kiyo9w/Autonomous-Car-IoT/Rescue_Rover_Report/frontmatter/acknowledgments.tex

% frontmatter/acknowledgments.tex - Acknowledgments
% ==================================================

\chapter*{Acknowledgments}
\addcontentsline{toc}{chapter}{Acknowledgments}

We would like to express our sincere gratitude to all those who have contributed to the successful completion of this project.

\vspace{0.5cm}

First and foremost, we extend our heartfelt thanks to our instructor, \textbf{Professor Du Dinh Vien}, for their invaluable guidance, continuous support, and constructive feedback throughout the development of the Rescue Rover project. Their expertise in networking and data communication has been instrumental in shaping our technical approach.

\vspace{0.5cm}

We are grateful to the \textbf{School of Information and Communication Technology} at Hanoi University of Science and Technology for providing us with the necessary resources, laboratory facilities, and academic environment to conduct this research.

\vspace{0.5cm}

Special thanks to our fellow classmates and lab mates who provided helpful discussions, testing support, and moral encouragement during challenging phases of development.

\vspace{0.5cm}

We also acknowledge the open-source community for their contributions to the tools and libraries we used in this project, including the Arduino framework, NiceGUI, YOLOv8, and various Python packages that made our implementation possible.

\vspace{0.5cm}

Finally, we thank our families for their unwavering support and understanding during the long hours dedicated to this project.

\vspace{1cm}

\hfill --- The Rescue Rover Team
