kiyo9w/Autonomous-Car-IoT/Rescue_Rover_Report/frontmatter/acronyms.tex

% frontmatter/acronyms.tex - List of Abbreviations
% =================================================

\chapter*{List of Abbreviations}
\addcontentsline{toc}{chapter}{List of Abbreviations}

\begin{longtable}{@{}ll@{}}
    \toprule
    \textbf{Abbreviation} & \textbf{Full Form} \\
    \midrule
    \endhead
    
    % Hardware & Electronics
    ADC     & Analog-to-Digital Converter \\
    GPIO    & General Purpose Input/Output \\
    I\textsuperscript{2}C & Inter-Integrated Circuit \\
    LED     & Light Emitting Diode \\
    MCU     & Microcontroller Unit \\
    PCB     & Printed Circuit Board \\
    PSRAM   & Pseudo Static Random Access Memory \\
    PWM     & Pulse Width Modulation \\
    SPI     & Serial Peripheral Interface \\
    UART    & Universal Asynchronous Receiver-Transmitter \\
    
    \midrule
    % Communication Protocols
    ESP-NOW & Espressif's Proprietary Wireless Protocol \\
    HTTP    & Hypertext Transfer Protocol \\
    JSON    & JavaScript Object Notation \\
    MJPEG   & Motion JPEG \\
    REST    & Representational State Transfer \\
    TCP     & Transmission Control Protocol \\
    UDP     & User Datagram Protocol \\
    WiFi    & Wireless Fidelity \\
    
    \midrule
    % AI & Computer Vision
    AI      & Artificial Intelligence \\
    CNN     & Convolutional Neural Network \\
    CV      & Computer Vision \\
    FPS     & Frames Per Second \\
    LLM     & Large Language Model \\
    ML      & Machine Learning \\
    VLM     & Vision Language Model \\
    YOLO    & You Only Look Once \\
    
    \midrule
    % Project-Specific
    API     & Application Programming Interface \\
    IoT     & Internet of Things \\
    ROV     & Remotely Operated Vehicle \\
    SDK     & Software Development Kit \\
    UI      & User Interface \\
    
    \midrule
    % Sensors & Components
    OV2640  & OmniVision 2640 Camera Sensor \\
    L298N   & Dual H-Bridge Motor Driver IC \\
    ToF     & Time of Flight \\
    
    \midrule
    % Standards & Units
    Hz      & Hertz \\
    kHz     & Kilohertz \\
    MHz     & Megahertz \\
    mA      & Milliampere \\
    mAh     & Milliampere-hour \\
    V       & Volt \\
    
    \bottomrule
\end{longtable}
