kiyo9w/Autonomous-Car-IoT/Rescue_Rover_Report/frontmatter/declaration.tex

% frontmatter/declaration.tex - Academic Declaration
% ===================================================

\chapter*{Declaration}
\addcontentsline{toc}{chapter}{Declaration}

We hereby declare that this project report titled \textbf{``Rescue Rover: An IoT-Based Autonomous Rescue Robot System''} submitted to \textbf{Hanoi University of Science and Technology} is a record of original work done by us under the guidance of our supervisor.

\vspace{1cm}

We further declare that:

\begin{enumerate}
    \item The work presented in this report has not been submitted elsewhere for any other degree or professional qualification.
    
    \item All sources of information and literature used in this work have been duly acknowledged through appropriate citations and references.
    
    \item The software code, hardware designs, and methodologies presented here are our own original work, except where explicitly stated otherwise.
    
    \item We understand that any instance of academic dishonesty may result in disciplinary action as per the university regulations.
\end{enumerate}

\vspace{2cm}

\noindent
\begin{tabular}{@{}p{0.45\textwidth}p{0.45\textwidth}@{}}
    \hrulefill & \hrulefill \\
    Ngo Thanh Trung & Date \\[1.5cm]
    \hrulefill & \hrulefill \\
    Pham Thai Duong & Date \\[1.5cm]
    \hrulefill & \hrulefill \\
    Nguyen Van Duc & Date \\[1.5cm]
    \hrulefill & \hrulefill \\
    Le Quang Huy & Date \\
\end{tabular}
