kiyo9w/Autonomous-Car-IoT/Rescue_Rover_Report/frontmatter/titlepage.tex

% frontmatter/titlepage.tex - Title Page
% =======================================

\begin{titlepage}
    \centering
    
    % University Logo (placeholder - add your university logo)
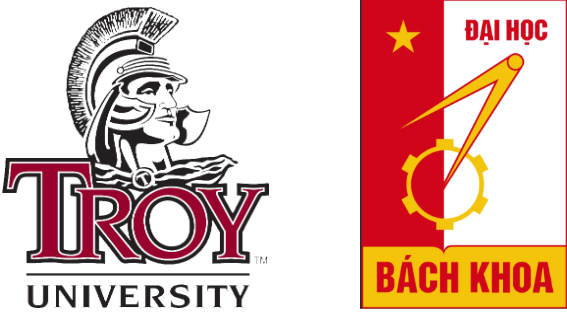
[picture p37: Rescue_Rover_Report/figures/university_logo.png]
    
    
    \vspace{0.5cm}
    
    {\scshape\LARGE Hanoi University of Science and Technology \par}
    \vspace{0.3cm}
    {\scshape\Large Faculty of Mathematics and Computer Science \par}
    
    \vspace{2cm}
    
    {\huge\bfseries Rescue Rover \par}
    \vspace{0.3cm}
    {\Large\itshape An IoT-Based Autonomous Rescue Robot System \par}
    
    \vspace{2cm}
    
    {\Large Project Report \par}
    \vspace{0.3cm}
    {\large CS 4445 - Data Communication and Networking \par}
    
    \vfill
    
    % Authors
    \begin{tabular}{rl}
        \textbf{Team Members:} & \\
        & Ngo Thanh Trung (1677469) \\
        & Pham Thai Duong (1677593) \\
        & Nguyen Duy Duc (1624838) \\
        & Le Quang Huy (1677645) \\
    \end{tabular}
    
    \vspace{1cm}
    
    \begin{tabular}{rl}
        \textbf{Instructor:} & Professor Du Dinh Vien \\
    \end{tabular}
    
    \vfill
    
    % Date
    {\large January 2026 \par}
    
\end{titlepage}
