kiyo9w/Autonomous-Car-IoT/Rescue_Rover_Report/figures/hardware/dc_motor_gearbox.jpeg

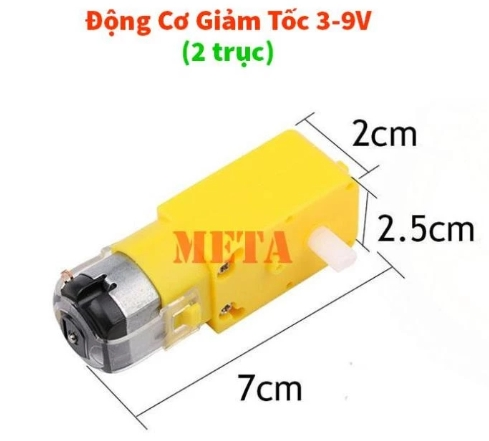
Rescue_Rover_Report/figures/hardware/dc_motor_gearbox.jpeg
