kiyo9w/Autonomous-Car-IoT/context/project_context/shopping.md

Here is the comprehensive cart audit and BOM analysis converted into structured Markdown, maintaining the technical details and pricing from the source documents.

---

# Final Comprehensive Cart Audit

## 1. Inventory Check: Current Orders

**Status:** **95% Complete** (Electronics & Mechanical largely secured) 

### Electronics (All Present)

| Component | Status | Price (VND) | Notes |
| --- | --- | --- | --- |
| **ESP32-S3 Sense N16R8** | Shipping | 163,800₫ | Ready to ship (Dec 07-12) 

 |
| **ESP32 DevKit CP2102 38P** | Ordered | 109,998₫ | Shop: Kho Linh Kiện Giá Si 

 |
| **L298N Motor Driver** | Ordered | 48,398₫ | Shop: A Linh Kiện 

 |
| **LM2596 Buck 5V/3A** | Ordered | 16,748₫ | Shop: Điện Tử Dân Dụng 24H 

 |
| **HC-SR04 Ultrasonic** | Ordered | 38,449₫ | Shop: Nhập Si Linh Kiện 

 |
| **MicroSD 16GB Kingston** | Ordered | 92,198₫ | Shop: Rflashdrive.vn 

 |
| **Samsung 20R Battery (x2)** | Ordered | 74,050₫ | 44,999₫/each 

 |
| **18650 Holder 2S** | Ordered | 36,058₫ | Series connection (Nối tiếp) 

 |
| **Capacitors 1000uF 16V (x2)** | Ordered | 36,258₫ | Shop: Bán Buôn Linh Kiện 

 |
| **Dupont Wire F-F 40P** | Ordered | 14,866₫ | Shop: Thế Giới Linh Kiện LiKi 

 |

### Mechanical (All Present - See Warning Below)

| Component | Status | Price (VND) | Notes |
| --- | --- | --- | --- |
| **BO Motors + Wheels (x4)** | Ordered | 80,237₫ | Shop: Điện Tử Sáng Tạo META 

 |
| **Chassis (Aluminum U-Shape)** | Ordered | 93,450₫ | Shop: Linh kiện điện tử SMD 

 |

---

## 2. Critical Missing Items (High Priority)

**You cannot program or power the robot without these items.** 

### 🔴 1. USB-C Cable (Data-Capable)

* 
**Cost:** ~30,000₫ 

* 
**Why Critical:** Required to flash firmware to the **ESP32-S3 Sense**. 

* **Spec Requirement:** Must support **Data Transfer** (charge-only cables will fail). Length 1-2m recommended. 

### 🔴 2. Micro-USB Cable (Data-Capable)

* 
**Cost:** ~15,000₫ 

* 
**Why Critical:** Required to flash firmware to the **ESP32 DevKit (Gateway)**. 

* 
**Spec Requirement:** Must support **Data Transfer**. 

---

## 3. Recommended Items (Medium Priority)

### 🟡 3. Rocker Switch (ON/OFF)

* 
**Cost:** ~5,000₫ 

* **Purpose:** Battery power control. The ordered 18650 holder **does not** have a built-in switch. 

* 
**Risk:** Without this, you must manually disconnect wires to turn the robot off. 

### 🟡 4. Heat Shrink Tubing

* 
**Cost:** ~10,000₫ 

* 
**Spec:** 2-3mm diameter, ~1m length. 

* 
**Purpose:** Protecting soldered connections and preventing shorts. 

---

## 4. ▲ Engineering Risk: Chassis Type

**Warning:** You ordered the "Khung nhôm Robot 4 bánh chữ U" (Aluminum U-shaped chassis). 

**Technical Concerns:** 

1. 
**Single Layer:** May not provide a second platform for electronics (batteries + drivers + ESP32s). 

2. 
**Structural:** "U-shaped" often implies a frame rather than a full platform. 

3. 
**Verification Needed:** Upon arrival, check for mounting holes for  motors and sufficient surface area for components. 

**Mitigation:** If unsuitable, be prepared to order an **Acrylic 2-layer chassis (~70k)**. 

---

## 5. Cost Summary

### Expenses Breakdown

| Category | Cost (VND) |
| --- | --- |
| **Already Ordered** | <br>**804,510₫** 

 |
| Missing Cables (Min) | 45,000₫ 

 |
| Recommended Extras | 30,000₫ 

 |
| **Project Total (Est)** | <br>**849,510₫** 

 |

### Remaining Budget Allocation

* 
**USB-C Cable:** 30,000₫ 

* 
**Micro-USB Cable:** 15,000₫ 

* 
**Switch/Shrink/Wires:** ~25,000₫ 

* 
**Buffer (Chassis Backup):** ~70,000₫ 

---

## 6. Action Items Checklist

Immediate Actions (Urgent) 

* [ ] **Order USB-C Data Cable:** Search "Cáp USB-C data". Verify "Data Transfer". (~30k) 

* [ ] **Order Micro-USB Data Cable:** Search "Cáp Micro-USB data". Verify "Data Transfer". (~15k) 

Recommended Actions 

* [ ] **Order Rocker Switch:** Search "Công tắc gạt 2 chân". SPST, ≥2A. (~5k) 

* [ ] **Order Heat Shrink:** Search "Ống co nhiệt", 2-3mm. (~10k) 

Upon Arrival 

* [ ] **Verify Chassis:** Ensure it holds motors and electronics securely.
* [ ] **Inventory Check:** Confirm all electronics powered on.

---

## 7. Final BOM vs Actual Comparison

| Category | Item | Status | Result |
| --- | --- | --- | --- |
| **Boards** | ESP32-S3 + DevKit | Ordered | ✔ OK |
| **Motor Control** | L298N + Motors + Wheels | Ordered | ✔ OK |
| **Power** | 18650 Batts + Holder + Buck | Ordered | ✔ OK |
| **Sensors** | HC-SR04 | Ordered | ✔ OK |
| **Wiring** | Dupont + Caps | Ordered | ✔ OK |
| **Mechanical** | Chassis | Ordered | <br>**▲ VERIFY** 

 |
| **Cables** | USB-C (Data) | **MISSING** | <br>**X CRITICAL** 

 |
| **Cables** | Micro-USB (Data) | **MISSING** | <br>**X CRITICAL** 

 |
| **Switch** | Rocker Switch | **MISSING** | <br>**X RECOMMENDED** 

 |

---

### **TL;DR**

You are **missing cables** required to program the boards. Buy **1x USB-C Data Cable** and **1x Micro-USB Data Cable** immediately (~45k total). Everything else is ordered.

Outside of these we also brought another replacement Camera for ESP32-S3 Sense N16R8 80k, soldering from local mechanical components supplier for the pin to the ESP S3 for 50k, resistor for 10k, and some few more stuff :]]
