kiyo9w/Autonomous-Car-IoT/Driver_Module/RescueRobot/PinConfig.h

#ifndef PIN_CONFIG_H
#define PIN_CONFIG_H


#define PIN_LEFT_FWD  39   // Thay cho chân 1 (TX)
#define PIN_LEFT_BWD  40   // Thay cho chân 2 (Boot)

// Motor Phải (41, 42 là lựa chọn tốt)
#define PIN_RIGHT_BWD 41  
#define PIN_RIGHT_FWD 42


#define PIN_ULTRASONIC_TRIG  2   

// Echo: Chân nhận tín hiệu (Input) -> CẦN CẦU PHÂN ÁP về 3.3V
#define PIN_ULTRASONIC_ECHO  3
#endif
