kiyo9w/Autonomous-Car-IoT/(commit log)

2026-01-10 File test kết nối ESP
2026-01-11 Driver-Motor Controller and esp32s3 connection
2026-01-14 cameraFixing & connection for esp32
2026-01-15 driver module
2026-01-15 camera esp32 changed
2026-01-15 "apply connection, camera"
2026-01-15 update driver
