kiyo9w/Autonomous-Car-IoT/(notices)

Notices in the files:
README.md:
License: MIT
