kiyo9w/Autonomous-Car-IoT/Rescue_Rover_Report/figures/hardware/wiring_photo.JPG

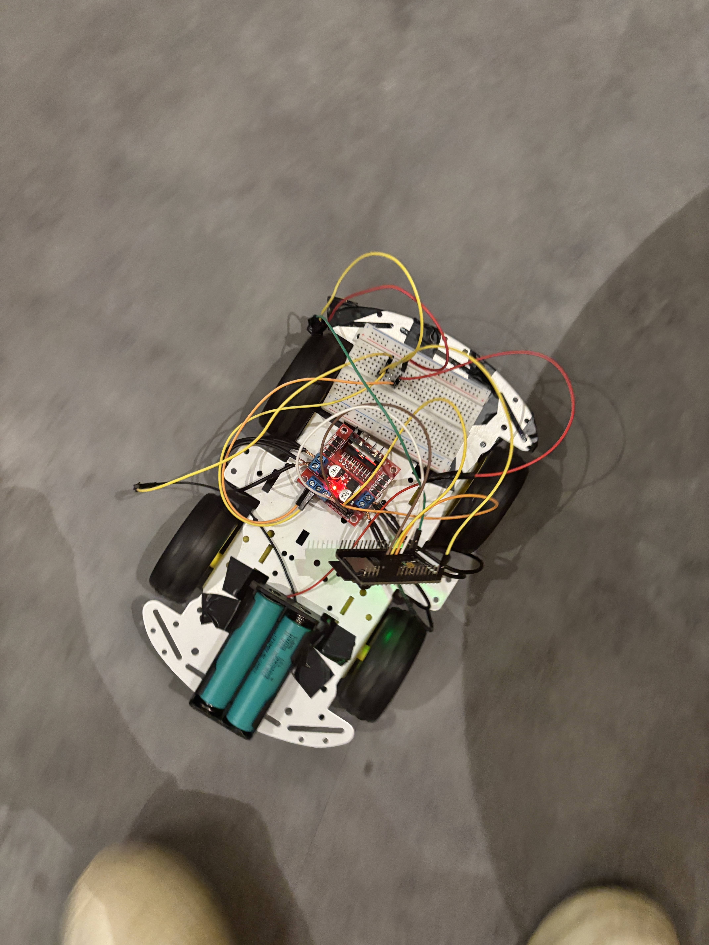
[picture p20: Rescue_Rover_Report/figures/hardware/wiring_photo.JPG]
Rescue_Rover_Report/figures/hardware/wiring_photo.JPG
